RainEggplant/oscilloscope_pong/src/constraints/ego1.xdc

# System clock
set_property -dict {PACKAGE_PIN P17 IOSTANDARD LVCMOS33} [get_ports {sysclk}]
create_clock -period 10.000 -name CLK -waveform {0.000 5.000} [get_ports {sysclk}]

# Button S2
set_property -dict {PACKAGE_PIN R15 IOSTANDARD LVCMOS33} [get_ports {reset}]

# Communicate with ADC analog circuit
set_property -dict {PACKAGE_PIN H17 IOSTANDARD LVCMOS33} [get_ports {select_v_ref}]
set_property -dict {PACKAGE_PIN K13 IOSTANDARD LVCMOS33} [get_ports {is_neg_v}]

# Seven-segment display
set_property -dict {PACKAGE_PIN B4 IOSTANDARD LVCMOS33} [get_ports {ssd[0]}]
set_property -dict {PACKAGE_PIN A4 IOSTANDARD LVCMOS33} [get_ports {ssd[1]}]
set_property -dict {PACKAGE_PIN A3 IOSTANDARD LVCMOS33} [get_ports {ssd[2]}]
set_property -dict {PACKAGE_PIN B1 IOSTANDARD LVCMOS33} [get_ports {ssd[3]}]
set_property -dict {PACKAGE_PIN A1 IOSTANDARD LVCMOS33} [get_ports {ssd[4]}]
set_property -dict {PACKAGE_PIN B3 IOSTANDARD LVCMOS33} [get_ports {ssd[5]}]
set_property -dict {PACKAGE_PIN B2 IOSTANDARD LVCMOS33} [get_ports {ssd[6]}]

# Seven-segment display BIT
set_property -dict {PACKAGE_PIN C2 IOSTANDARD LVCMOS33} [get_ports {ssd_bit[0]}]
set_property -dict {PACKAGE_PIN C1 IOSTANDARD LVCMOS33} [get_ports {ssd_bit[1]}]
set_property -dict {PACKAGE_PIN H1 IOSTANDARD LVCMOS33} [get_ports {ssd_bit[2]}]

# X output
set_property -dict {PACKAGE_PIN B17 IOSTANDARD LVCMOS33} [get_ports {x[0]}]
set_property -dict {PACKAGE_PIN A16 IOSTANDARD LVCMOS33} [get_ports {x[1]}]
set_property -dict {PACKAGE_PIN A14 IOSTANDARD LVCMOS33} [get_ports {x[2]}]
set_property -dict {PACKAGE_PIN A18 IOSTANDARD LVCMOS33} [get_ports {x[3]}]
set_property -dict {PACKAGE_PIN F14 IOSTANDARD LVCMOS33} [get_ports {x[4]}]
set_property -dict {PACKAGE_PIN B14 IOSTANDARD LVCMOS33} [get_ports {x[5]}]
set_property -dict {PACKAGE_PIN C14 IOSTANDARD LVCMOS33} [get_ports {x[6]}]
set_property -dict {PACKAGE_PIN A11 IOSTANDARD LVCMOS33} [get_ports {x[7]}]

# Y output
set_property -dict {PACKAGE_PIN B16 IOSTANDARD LVCMOS33} [get_ports {y[0]}]
set_property -dict {PACKAGE_PIN A15 IOSTANDARD LVCMOS33} [get_ports {y[1]}]
set_property -dict {PACKAGE_PIN A13 IOSTANDARD LVCMOS33} [get_ports {y[2]}]
set_property -dict {PACKAGE_PIN B18 IOSTANDARD LVCMOS33} [get_ports {y[3]}]
set_property -dict {PACKAGE_PIN F13 IOSTANDARD LVCMOS33} [get_ports {y[4]}]
set_property -dict {PACKAGE_PIN B13 IOSTANDARD LVCMOS33} [get_ports {y[5]}]
set_property -dict {PACKAGE_PIN D14 IOSTANDARD LVCMOS33} [get_ports {y[6]}]
set_property -dict {PACKAGE_PIN B11 IOSTANDARD LVCMOS33} [get_ports {y[7]}]
