RainEggplant/oscilloscope_pong/src/design_src/bin_to_bcd.v

module bin_to_bcd(
         bin, hundreds, tens, ones
       );
input [7:0] bin;
output reg [3:0] hundreds;
output reg [3:0] tens;
output reg [3:0] ones;

// Internal variable for storing bits
reg [19:0] shift;
integer i;

always @ (bin)
  begin
    // Clear previous number and store new number in shift register
    shift[19:8] = 0;
    shift[7:0] = bin;

    // Loop eight times
    for (i = 0; i < 8; i = i + 1)
      begin
        if (shift[11:8] >= 5)
          shift[11:8] = shift[11:8] + 3;

        if (shift[15:12] >= 5)
          shift[15:12] = shift[15:12] + 3;

        if (shift[19:16] >= 5)
          shift[19:16] = shift[19:16] + 3;

        // Shift entire register left once
        shift = shift << 1;
      end

    // Push decimal numbers to output
    hundreds = shift[19:16];
    tens = shift[15:12];
    ones = shift[11:8];
  end

endmodule
