RainEggplant/oscilloscope_pong/(commit log)

2019-08-28 ver 0.1, no plate voltage in
2019-08-28 ver 0.2: add border & ADC
